SVeilleux9/STM-LED-Driver/hardware/LEDnumbering.png

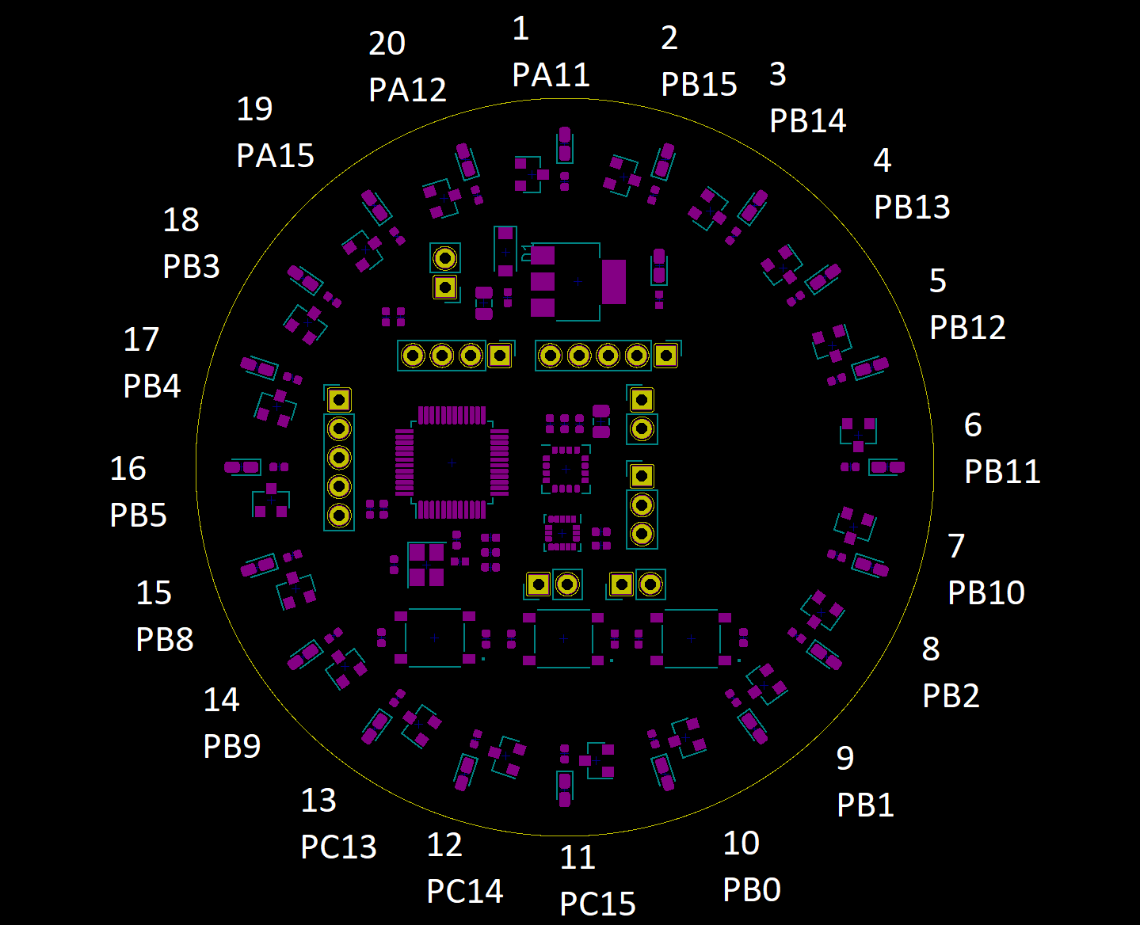
hardware/LEDnumbering.png
