SVeilleux9/STM-LED-Driver/hardware/LED-Driver-STM.kicad_pcb

## KiCad design hardware/LED-Driver-STM.kicad_pcb (2020-10-13)

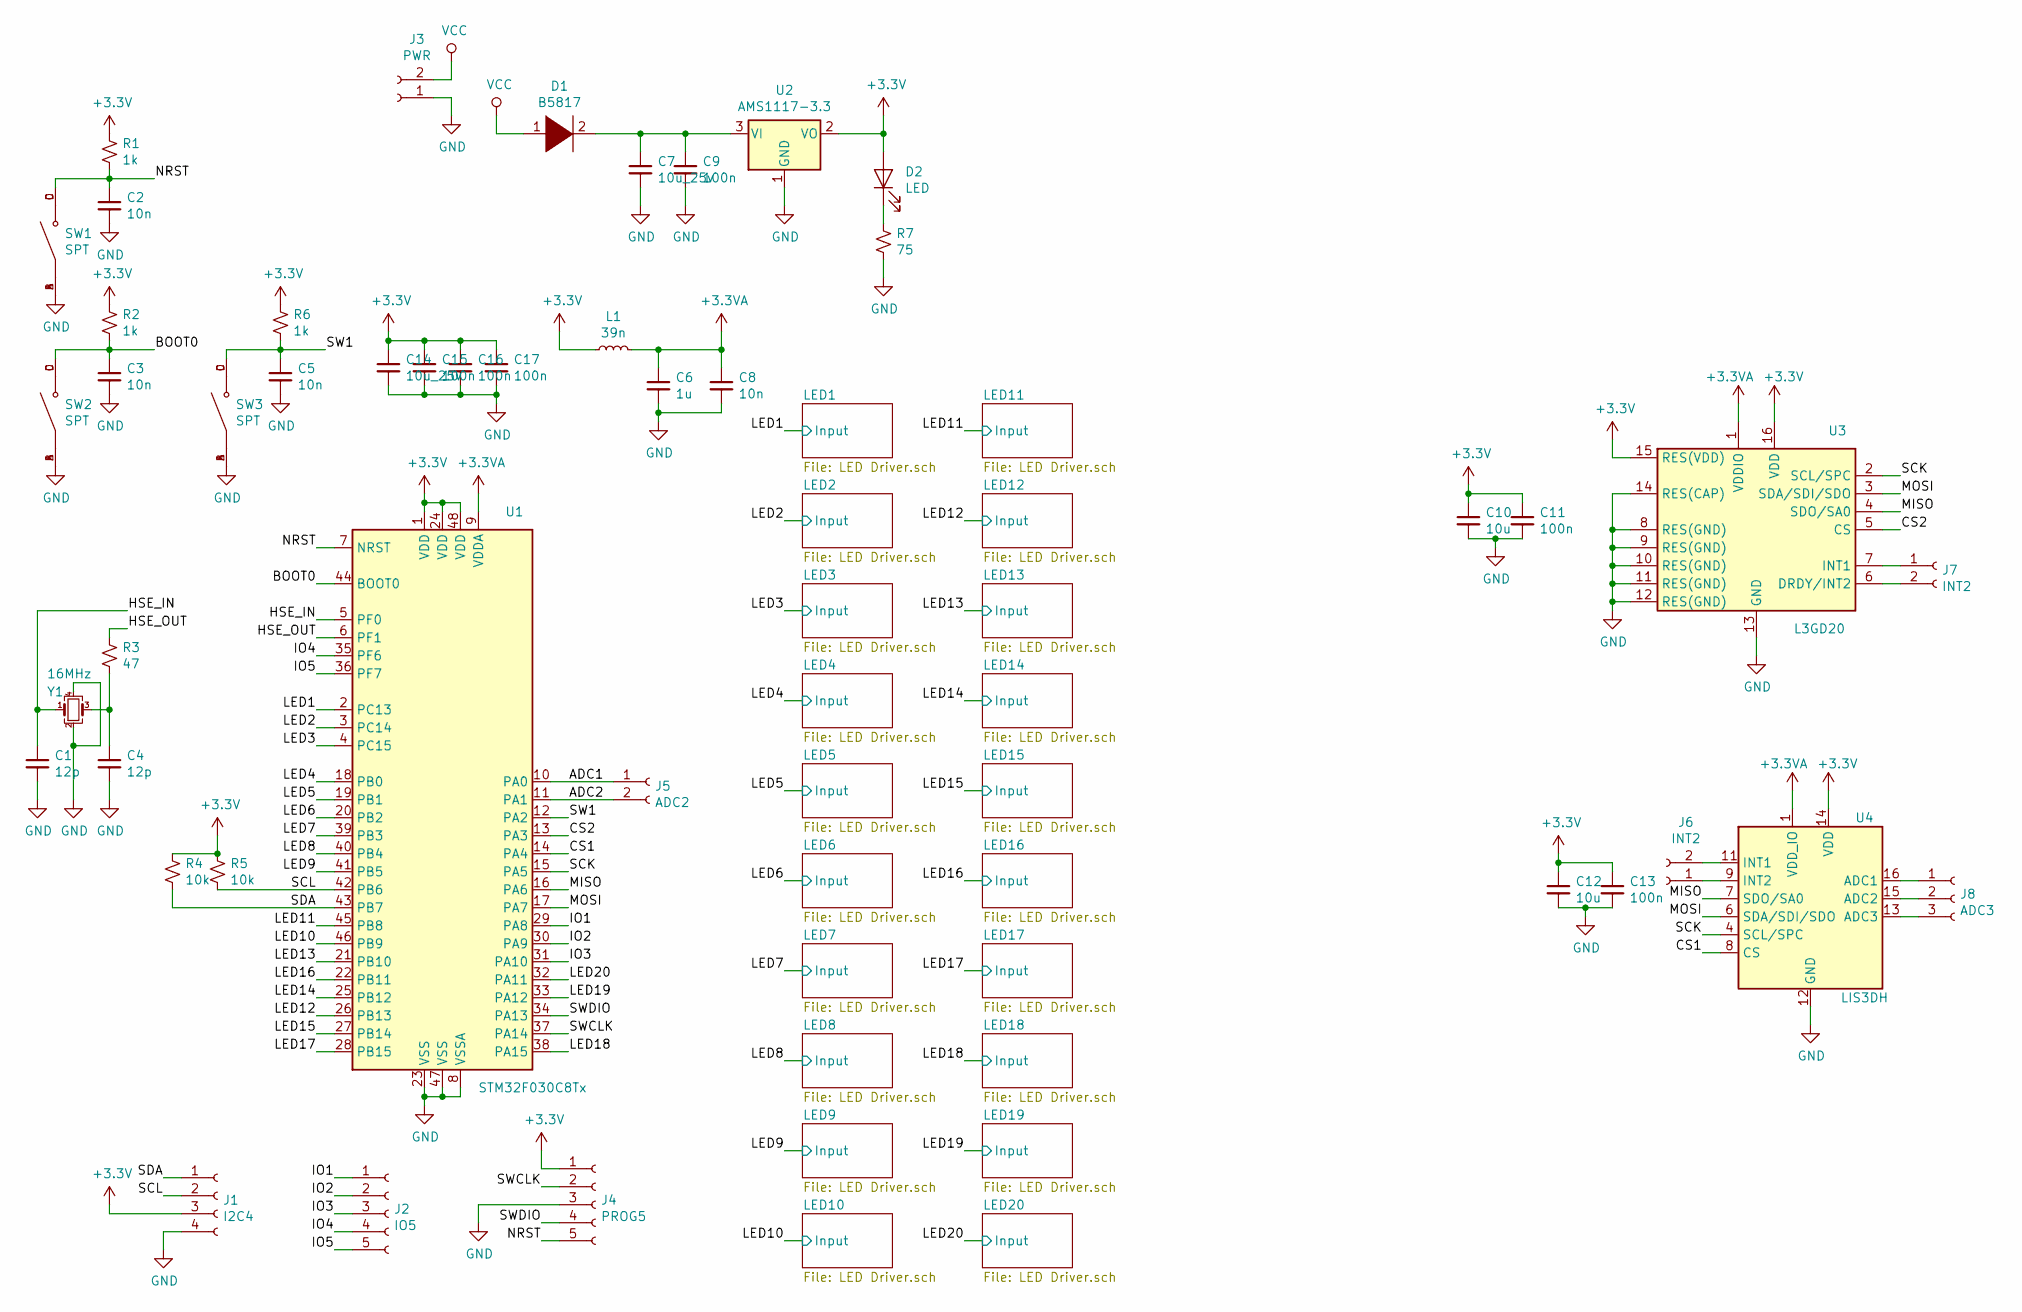
[picture p2: schematic LED-Driver-STM.sch]

Parts:
C1, C4: 12p; C_0402_1005Metric; LCSC Part # C1547
C2, C3, C5, C8: 10n; C_0402_1005Metric; LCSC Part # C15195
C6: 1u; C_0402_1005Metric; LCSC Part # C52923
C7, C14: 10u_25v; C_0805_2012Metric; LCSC Part # C15850
C9, C11, C13, C15, C16, C17: 100n; C_0402_1005Metric; LCSC Part # C1525
C10, C12: 10u; C_0402_1005Metric; LCSC Part # C15525
D1: B5817; D_SOD-123; LCSC Part # C8598
D2: LED; LED_0603_1608Metric_Castellated; LCSC Part # C2286
J1: I2C4; PinHeader_1x04_P2.54mm_Vertical
J2: IO5; PinHeader_1x05_P2.54mm_Vertical
J3: PWR; PinHeader_1x02_P2.54mm_Vertical
J4: PROG5; PinHeader_1x05_P2.54mm_Vertical
J5: ADC2; PinHeader_1x02_P2.54mm_Vertical
J6, J7: INT2; PinHeader_1x02_P2.54mm_Vertical
J8: ADC3; PinHeader_1x03_P2.54mm_Vertical
L1: 39n; L_0402_1005Metric; LCSC Part # C26443
R1, R2, R6: 1k; R_0402_1005Metric; LCSC Part # C11702
R3: 47; R_0402_1005Metric; LCSC Part # C25118
R4, R5: 10k; R_0402_1005Metric; LCSC Part # C25744
R7: 75; R_0402_1005Metric; LCSC Part # C25133
SW1, SW2, SW3: SPT; SW_TS-1187A-B-A-B; LCSC Part # C318884
U1: STM32F030C8Tx; LQFP-48_7x7mm_P0.5mm; LCSC Part # C23922
U2: AMS1117-3.3; SOT-223-3_TabPin2; LCSC Part # C6186
U3: L3GD20; LGA-16_4x4mm_P0.65mm_LayoutBorder4x4y; LCSC Part # C26444
U4: LIS3DH; LGA-16_3x3mm_P0.5mm_LayoutBorder3x5y; LCSC Part # C15134
Y1: 16MHz; Crystal_SMD_3225-4Pin_3.2x2.5mm; LCSC Part # C13738

Connections:
+3.3VA: C6.1, C8.1, L1.2, U1.9 (VDDA), U3.1 (VDDIO), U4.1 (VDD_IO)
+3V3: C10.1, C11.1, C12.1, C13.1, C14.1, C15.1, C16.1, C17.1, D2.2 (A), J1.3, J4.1, L1.1, R1.1, R2.1, R4.1, R5.1, R6.1, U1.1 (VDD), U1.24 (VDD), U1.48 (VDD), U2.2 (VO), U3.15 (RES(VDD)), U3.16 (VDD), U4.14 (VDD); also elsewhere on the board
/ADC1: J5.1, U1.10 (PA0)
/ADC2: J5.2, U1.11 (PA1)
/BOOT0: C3.1, R2.2, SW2.C, SW2.D, U1.44 (BOOT0)
/CS1: U1.14 (PA4), U4.8 (CS)
/CS2: U1.13 (PA3), U3.5 (CS)
/HSE_IN: C1.1, U1.5 (PF0), Y1.1
/HSE_OUT: R3.1, U1.6 (PF1)
/IO1: J2.1, U1.29 (PA8)
/IO2: J2.2, U1.30 (PA9)
/IO3: J2.3, U1.31 (PA10)
/IO4: J2.4, U1.35 (PF6)
/IO5: J2.5, U1.36 (PF7)
/LED1: U1.2 (PC13); also elsewhere on the board
/LED2: U1.3 (PC14); also elsewhere on the board
/LED3: U1.4 (PC15); also elsewhere on the board
/LED4: U1.18 (PB0); also elsewhere on the board
/LED5: U1.19 (PB1); also elsewhere on the board
/LED6: U1.20 (PB2); also elsewhere on the board
/LED7: U1.39 (PB3); also elsewhere on the board
/LED8: U1.40 (PB4); also elsewhere on the board
/LED9: U1.41 (PB5); also elsewhere on the board
/LED10: U1.46 (PB9); also elsewhere on the board
/LED11: U1.45 (PB8); also elsewhere on the board
/LED12: U1.26 (PB13); also elsewhere on the board
/LED13: U1.21 (PB10); also elsewhere on the board
/LED14: U1.25 (PB12); also elsewhere on the board
/LED15: U1.27 (PB14); also elsewhere on the board
/LED16: U1.22 (PB11); also elsewhere on the board
/LED17: U1.28 (PB15); also elsewhere on the board
/LED18: U1.38 (PA15); also elsewhere on the board
/LED19: U1.33 (PA12); also elsewhere on the board
/LED20: U1.32 (PA11); also elsewhere on the board
/MISO: U1.16 (PA6), U3.4 (SDO/SA0), U4.7 (SDO/SA0)
/MOSI: U1.17 (PA7), U3.3 (SDA/SDI/SDO), U4.6 (SDA/SDI/SDO)
/NRST: C2.1, J4.5, R1.2, SW1.C, SW1.D, U1.7 (NRST)
/SCK: U1.15 (PA5), U3.2 (SCL/SPC), U4.4 (SCL/SPC)
/SCL: J1.2, R5.2, U1.42 (PB6)
/SDA: J1.1, R4.2, U1.43 (PB7)
/SW1: C5.1, R6.2, SW3.C, SW3.D, U1.12 (PA2)
/SWCLK: J4.2, U1.37 (PA14)
/SWDIO: J4.4, U1.34 (PA13)
GND: C1.2, C2.2, C3.2, C4.2, C5.2, C6.2, C7.2, C8.2, C9.2, C10.2, C11.2, C12.2, C13.2, C14.2, C15.2, C16.2, C17.2, J1.4, J3.1, J4.3, R7.2, SW1.A, SW1.B, SW2.A, SW2.B, SW3.A, SW3.B, U1.8 (VSSA), U1.23 (VSS), U1.47 (VSS), U2.1 (GND), U3.8 (RES(GND)), U3.9 (RES(GND)), U3.10 (RES(GND)), U3.11 (RES(GND)), U3.12 (RES(GND)), U3.13 (GND), U3.14 (RES(CAP)), U4.5 (GND), U4.10 (GND), U4.12 (GND), Y1.2, Y1.4; also elsewhere on the board
unnamed: C4.1, R3.2, Y1.3
unnamed: C7.1, C9.1, D1.2 (A), U2.3 (VI)
unnamed: D2.1 (K), R7.1
unnamed: J6.1, U4.9 (INT2)
unnamed: J6.2, U4.11 (INT1)
unnamed: J7.1, U3.7 (INT1)
unnamed: J7.2, U3.6 (DRDY/INT2)
unnamed: J8.1, U4.16 (ADC1)
unnamed: J8.2, U4.15 (ADC2)
unnamed: J8.3, U4.13 (ADC3)
VCC: D1.1 (K), J3.2

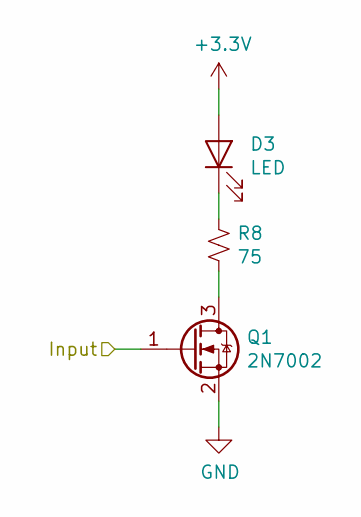
[picture p3: schematic LED Driver.sch]

Parts:
D4: LED; LED_0603_1608Metric_Castellated; LCSC Part # C2286
Q1: 2N7002; SOT-23; LCSC Part # C8545
R9: 75; R_0402_1005Metric; LCSC Part # C25133

Connections:
+3V3: D4.2 (A); also elsewhere on the board
/LED1: Q1.1 (G); also elsewhere on the board
GND: Q1.2 (S); also elsewhere on the board
unnamed: D4.1 (K), R9.1

Parts of its further copies:
D3, D5, D6, D7, D8, D9, D10, D11, D12, D13, D14, D15, D16, D17, D18, D19, D20, D21, D22: LED; LED_0603_1608Metric_Castellated; LCSC Part # C2286
Q2, Q3, Q4, Q5, Q6, Q7, Q8, Q9, Q10, Q11, Q12, Q13, Q14, Q15, Q16, Q17, Q18, Q19, Q20: 2N7002; SOT-23; LCSC Part # C8545
R8, R10, R11, R12, R13, R14, R15, R16, R17, R18, R19, R20, R21, R22, R23, R24, R25, R26, R27: 75; R_0402_1005Metric; LCSC Part # C25133

Connections of its further copies:
+3V3: D3.2 (A), D5.2 (A), D6.2 (A), D7.2 (A), D8.2 (A), D9.2 (A), D10.2 (A), D11.2 (A), D12.2 (A), D13.2 (A), D14.2 (A), D15.2 (A), D16.2 (A), D17.2 (A), D18.2 (A), D19.2 (A), D20.2 (A), D21.2 (A), D22.2 (A); also elsewhere on the board
/LED2: Q2.1 (G); also elsewhere on the board
/LED3: Q3.1 (G); also elsewhere on the board
/LED4: Q4.1 (G); also elsewhere on the board
/LED5: Q5.1 (G); also elsewhere on the board
/LED6: Q6.1 (G); also elsewhere on the board
/LED7: Q7.1 (G); also elsewhere on the board
/LED8: Q8.1 (G); also elsewhere on the board
/LED9: Q9.1 (G); also elsewhere on the board
/LED10: Q10.1 (G); also elsewhere on the board
/LED11: Q11.1 (G); also elsewhere on the board
/LED12: Q12.1 (G); also elsewhere on the board
/LED13: Q13.1 (G); also elsewhere on the board
/LED14: Q14.1 (G); also elsewhere on the board
/LED15: Q15.1 (G); also elsewhere on the board
/LED16: Q16.1 (G); also elsewhere on the board
/LED17: Q17.1 (G); also elsewhere on the board
/LED18: Q18.1 (G); also elsewhere on the board
/LED19: Q19.1 (G); also elsewhere on the board
/LED20: Q20.1 (G); also elsewhere on the board
GND: Q2.2 (S), Q3.2 (S), Q4.2 (S), Q5.2 (S), Q6.2 (S), Q7.2 (S), Q8.2 (S), Q9.2 (S), Q10.2 (S), Q11.2 (S), Q12.2 (S), Q13.2 (S), Q14.2 (S), Q15.2 (S), Q16.2 (S), Q17.2 (S), Q18.2 (S), Q19.2 (S), Q20.2 (S); also elsewhere on the board
unnamed: D3.1 (K), R8.1
unnamed: D5.1 (K), R10.1
unnamed: D6.1 (K), R11.1
unnamed: D7.1 (K), R12.1
unnamed: D8.1 (K), R13.1
unnamed: D9.1 (K), R14.1
unnamed: D10.1 (K), R15.1
unnamed: D11.1 (K), R16.1
unnamed: D12.1 (K), R17.1
unnamed: D13.1 (K), R18.1
unnamed: D14.1 (K), R19.1
unnamed: D15.1 (K), R20.1
unnamed: D16.1 (K), R21.1
unnamed: D17.1 (K), R22.1
unnamed: D18.1 (K), R23.1
unnamed: D19.1 (K), R24.1
unnamed: D20.1 (K), R25.1
unnamed: D21.1 (K), R26.1
unnamed: D22.1 (K), R27.1
unnamed: Q3.3 (D), R10.2
unnamed: Q4.3 (D), R11.2
unnamed: Q5.3 (D), R12.2
unnamed: Q6.3 (D), R13.2
unnamed: Q7.3 (D), R14.2
unnamed: Q8.3 (D), R15.2
unnamed: Q9.3 (D), R16.2
unnamed: Q10.3 (D), R17.2
unnamed: Q11.3 (D), R18.2
unnamed: Q12.3 (D), R19.2
unnamed: Q13.3 (D), R20.2
unnamed: Q14.3 (D), R21.2
unnamed: Q15.3 (D), R22.2
unnamed: Q16.3 (D), R23.2
unnamed: Q17.3 (D), R24.2
unnamed: Q18.3 (D), R25.2
unnamed: Q19.3 (D), R26.2
unnamed: Q20.3 (D), R27.2

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
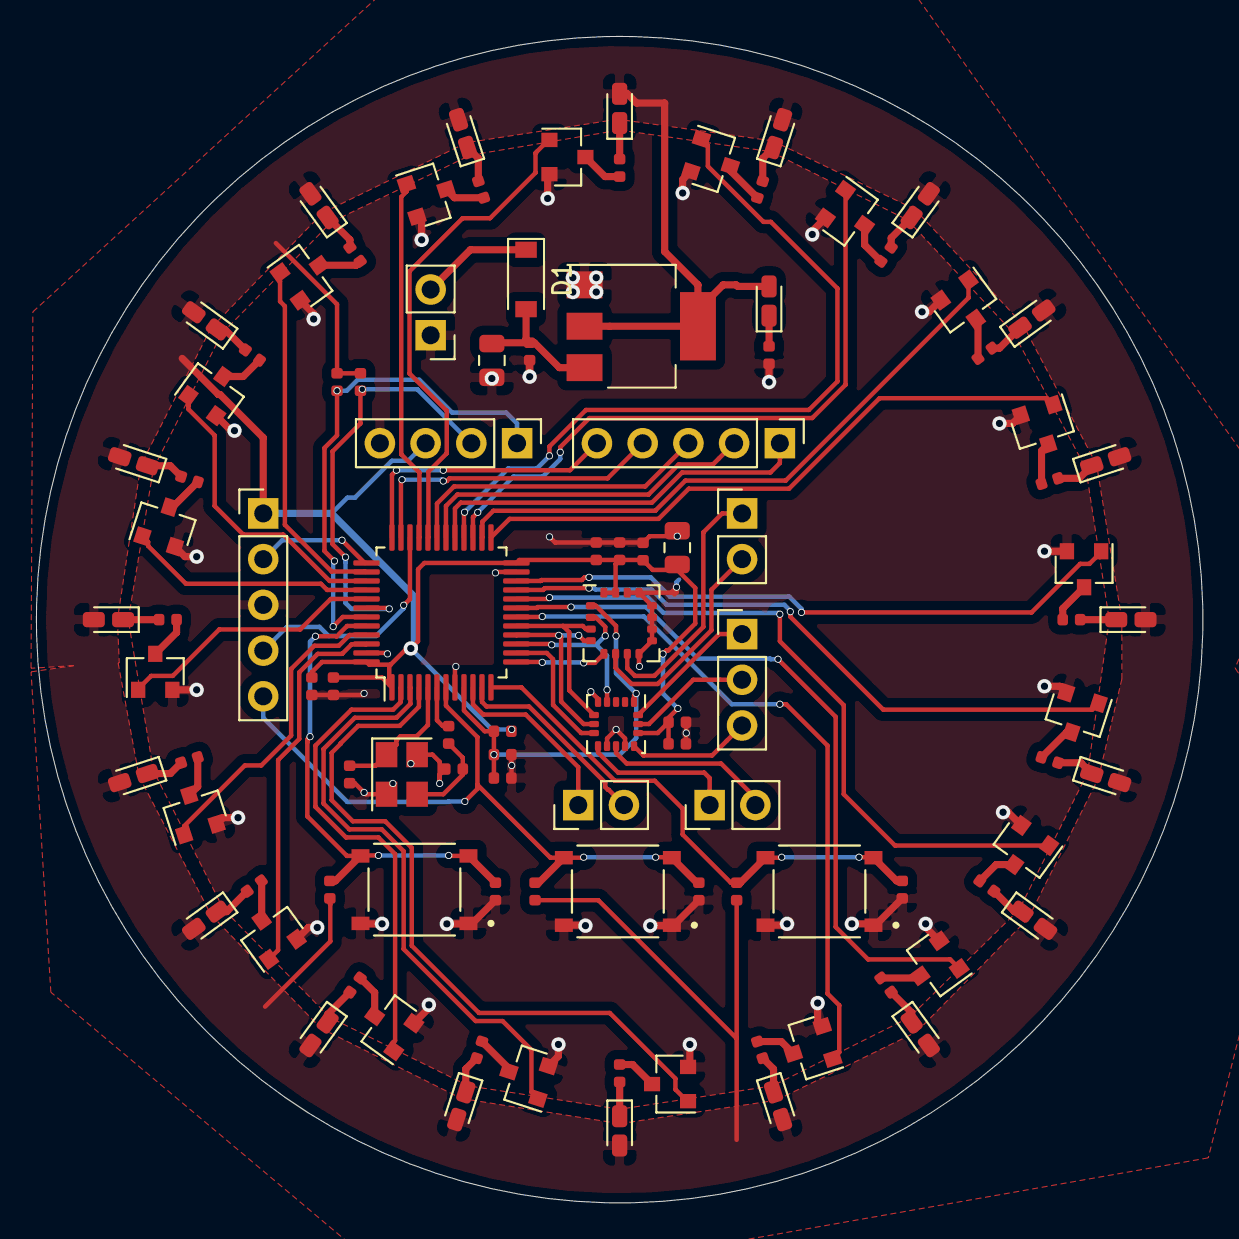
[picture p4: board LED-Driver-STM.kicad_pcb from above]

Board: 2 copper layers, 64.8 x 64.8 mm, 103 parts (0 on the bottom side), 95 nets.
