SVeilleux9/STM-LED-Driver/software/STM Led Driver/LED Driver STM.ioc

Mcu.UserName=STM32F030C8Tx
PA0.Signal=ADC_IN0
PA1.Signal=ADC_IN1
PA10.Signal=USART1_RX
PA11.Signal=GPIO_Output
PA12.Signal=GPIO_Output
PA13.Signal=SYS_SWDIO
PA14.Signal=SYS_SWCLK
PA15.Signal=GPIO_Output
PA4.Signal=GPIO_Output
PA5.Signal=SPI1_SCK
PA6.Signal=SPI1_MISO
PA7.Signal=SPI1_MOSI
PA9.Signal=USART1_TX
PB0.Signal=GPIO_Output
PB1.Signal=GPIO_Output
PB10.Signal=GPIO_Output
PB11.Signal=GPIO_Output
PB12.Signal=GPIO_Output
PB13.Signal=GPIO_Output
PB14.Signal=GPIO_Output
PB15.Signal=GPIO_Output
PB2.Signal=GPIO_Output
PB3.Signal=GPIO_Output
PB4.Signal=GPIO_Output
PB5.Signal=GPIO_Output
PB6.Signal=I2C1_SCL
PB7.Signal=I2C1_SDA
PB8.Signal=GPIO_Output
PB9.Signal=GPIO_Output
PC13.Signal=GPIO_Output
PC14-OSC32_IN.Signal=GPIO_Output
PC15-OSC32_OUT.Signal=GPIO_Output
PF0-OSC_IN.Signal=RCC_OSC_IN
PF1-OSC_OUT.Signal=RCC_OSC_OUT
