SVeilleux9/STM-LED-Driver/(commit log)

2020-09-27 Initial Schematic Design
    [LED Driver STM.kicad_pcb, LED Driver STM.sch, LED Driver.sch]
2020-09-27 Schematic Update
    - Added footprint for push buttons
    - Added headers for I2C pins
2020-09-27 Began Layout
    I have most of the components placed. Looks like the board will be about 65 mm diameter. Roughly 6.76 square inches (assuming 2.6x2.6 inch square.
2020-09-27 Updated layout
    [LED Driver STM-B_Cu.gbr, LED Driver STM-B_Mask.gbr, LED Driver STM-B_Paste.gbr, LED Driver STM-B_SilkS.gbr, LED Driver STM-Edge_Cuts.gbr, LED Driver STM-F_Cu.gbr, LED Driver STM-F_Mask.gbr, LED Driver STM-F_Paste.gbr]
2020-09-27 Finished Routing V1
    [LED Driver.sch, LED-Driver-STM-BOM.csv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]
2020-10-04 Latest board layout
    This is the board that was purchased
    [LED Driver.sch, LED-Driver-STM-BOM.csv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]
2020-10-08 Create LEDnumbering.png
    Added a figure to show which LEDs align which which pins
2020-10-13 Initial code
    Its gross and doesnt work well.
    [LED Driver.sch, LED-Driver-STM-BOM.csv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]
2020-10-14 SPI work
    I was able to read the register who_am_i on the LIS3DH
2020-10-17 Can do a SPI read but no write
    whyyyyyyyyyyyyyy
    [LED-Driver-STM.kicad_pcb]
2020-10-17 I think something is working?
    Maybe SPI is now working?
2020-10-24 Everything is working :)
    Currently the code is set to have the LED that is pointing down be turned on.
2020-10-28 Starting to make v2 board
    things to do:
    - Change to 4 layer board
    - Use 4 pack of resistors 0603x4 not 0402
    - Remove fly back diodes
    - Make high current runs shorter
    - General board shrink
    [LED Driver STM.ioc, main.cpp, run.cpp]
